cnlohr/magstock2018/revA/CompleteRevD.jpg

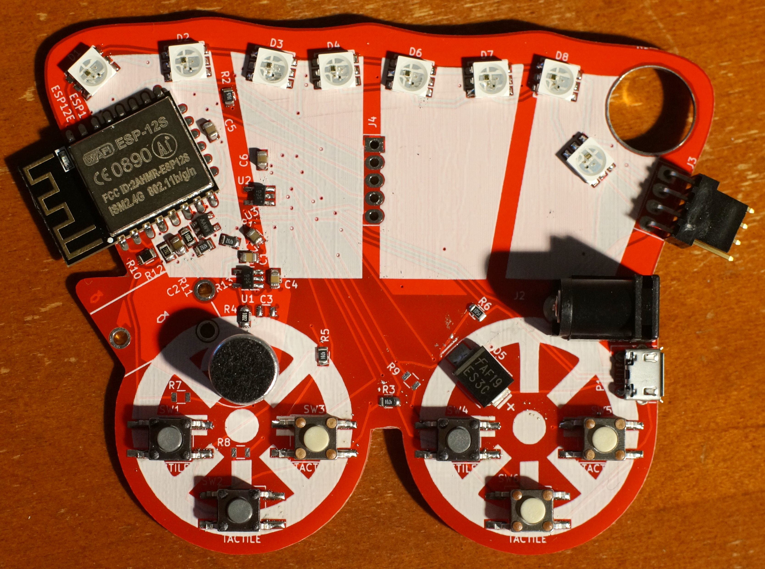
revA/CompleteRevD.jpg
