cnlohr/magstock2018/revA/WagonOutline.png

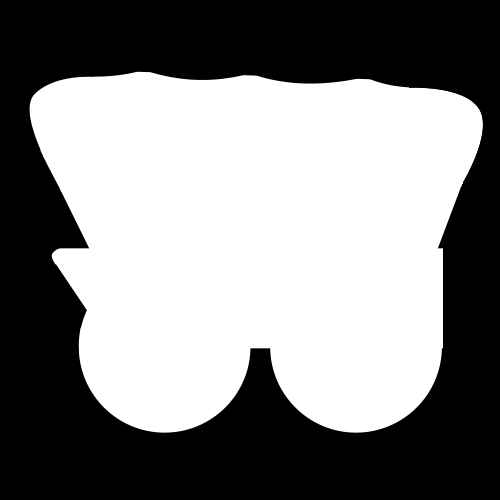
revA/WagonOutline.png
