cnlohr/magstock2018/revA/WagonSilk.png

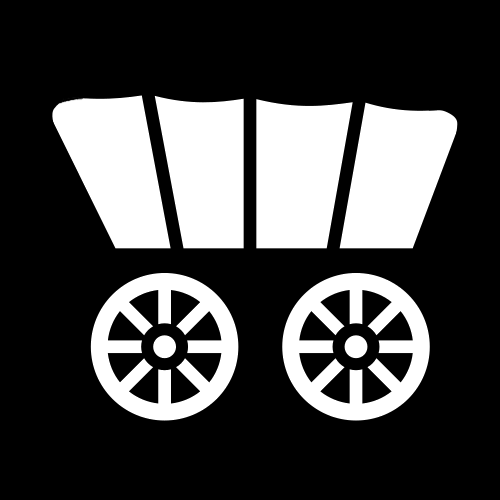
revA/WagonSilk.png
