cnlohr/magstock2018/revA/magstock2018A.kicad_pcb

## KiCad design revA/magstock2018A.kicad_pcb (2018-05-04)

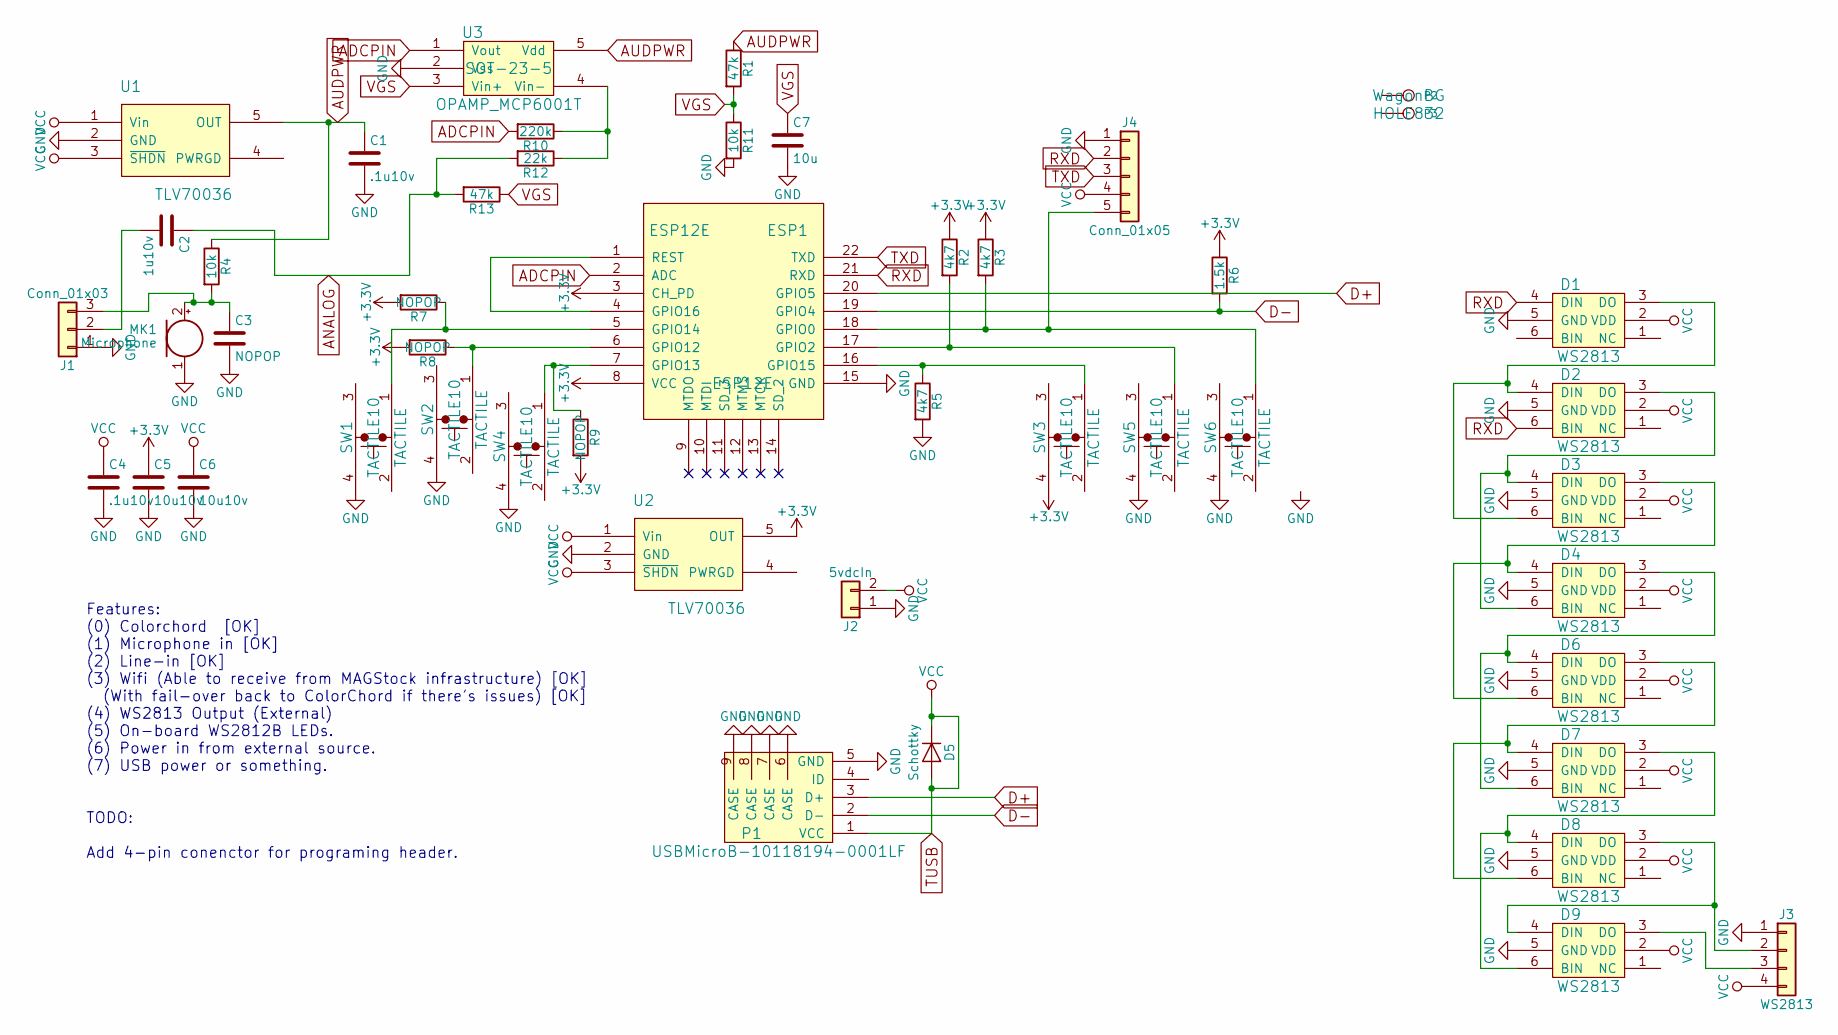
[picture p4: schematic magstock2018A.sch]

Parts:
C1, C4: .1u10v; R_0805
C2: 1u10v; R_0805
C3: NOPOP; R_0805
C5, C6: 10u10v; R_0805
C7: 10u; R_0805
D1, D2, D3, D4, D6, D7, D8, D9: WS2813
D5: Schottky; DO-214AB; Digikey SK36A R3GCT-ND
ESP1: ESP12E
J1: Conn_01x03; 3.5mm_barrel_jack_MJ-3536N; Digikey CP-3536N-ND
J2: 5vdcIn; PJ-037A; Digikey CP-037A-ND
J3: WS2813; Molex_KK-6410-04_04x2.54mm_Straight
J4: Conn_01x05; Molex_KK-6410-05_05x2.54mm_Straight
MK1: Microphone; CP_Radial_D10.0mm_P2.50mm_P5.00mm; Digikey 668-1460-ND
P1: USBMicroB-10118194-0001LF; USB_Micro-B_10103594-0001LF; Digikey 609-4050-1-ND
P2: CONN_1; WagonBG
P3: CONN_1; HOLE832
R1, R13: 47k; R_0805
R2, R3, R5: 4k7; R_0805
R4, R11: 10k; R_0805
R6: 1.5k; R_0805
R7, R8, R9: NOPOP; R_0805
R10: 220k; R_0805
R12: 22k; R_0805
SW1, SW2, SW3, SW4, SW5, SW6: TACTILE; TACTILE10; Digikey CKN9112CT-ND
U1, U2: TLV70036; SOT-23-5_HandSoldering; Digikey 296-40611-1-ND
U3: OPAMP_MCP6001T; SOT-23-5; Digikey MCP6001UT-I/OTCT-ND

Connections:
+3V3: C5.1, ESP1.3 (CH_PD), ESP1.8 (VCC), R2.1, R3.1, R6.1, R7.2, R8.2, R9.2, SW3.4, U2.5 (OUT)
ADCPIN: ESP1.2 (ADC), R10.2, U3.1 (Vout)
ANALOG: C2.1, R12.2, R13.2
AUDPWR: C1.1, R1.1, R4.1, U1.5 (OUT), U3.5 (Vdd)
D+: ESP1.20 (GPIO5), P1.3 (D+)
D-: ESP1.19 (GPIO4), P1.2 (D-), R6.2
GND: C1.2, C3.2, C4.2, C5.2, C6.2, C7.2, D1.5 (GND), D2.5 (GND), D3.5 (GND), D4.5 (GND), D6.5 (GND), D7.5 (GND), D8.5 (GND), D9.5 (GND), ESP1.15 (GND), J1.1, J2.1, J3.1, J4.1, MK1.1 (-), P1.5 (GND), P1.6 (CASE), P1.7 (CASE), P1.8 (CASE), P1.9 (CASE), R5.2, R11.2, SW1.4, SW2.4, SW4.4, SW5.4, SW6.4, U1.2 (GND), U2.2 (GND), U3.2 (Vss)
unnamed: C2.2, J1.2
unnamed: C3.1, J1.3, MK1.2 (+), R4.2
unnamed: D1.3 (DO), D2.4 (DIN), D3.6 (BIN)
unnamed: D2.3 (DO), D3.4 (DIN), D4.6 (BIN)
unnamed: D3.3 (DO), D4.4 (DIN), D6.6 (BIN)
unnamed: D4.3 (DO), D6.4 (DIN), D7.6 (BIN)
unnamed: D6.3 (DO), D7.4 (DIN), D8.6 (BIN)
unnamed: D7.3 (DO), D8.4 (DIN), D9.6 (BIN)
unnamed: D8.3 (DO), D9.4 (DIN), J3.2
unnamed: D9.3 (DO), J3.3
unnamed: ESP1.1 (REST), ESP1.4 (GPIO16)
unnamed: ESP1.5 (GPIO14), R7.1, SW1.1
unnamed: ESP1.6 (GPIO12), R8.1, SW2.1
unnamed: ESP1.7 (GPIO13), R9.1, SW4.1
unnamed: ESP1.16 (GPIO15), R5.1, SW3.1
unnamed: ESP1.17 (GPIO2), R2.2, SW5.1
unnamed: ESP1.18 (GPIO0), J4.5, R3.2, SW6.1
unnamed: R10.1, R12.1, U3.4 (Vin-)
RXD: D1.4 (DIN), D2.6 (BIN), ESP1.21 (RXD), J4.2
TUSB: C4.1, C6.1, D1.2 (VDD), D2.2 (VDD), D3.2 (VDD), D4.2 (VDD), D5.1 (K), D5.2 (A), D6.2 (VDD), D7.2 (VDD), D8.2 (VDD), D9.2 (VDD), J2.2, J3.4, J4.4, P1.1 (VCC), U1.1 (Vin), U1.3 (~SHDN), U2.1 (Vin), U2.3 (~SHDN)
TXD: ESP1.22 (TXD), J4.3
VGS: C7.1, R1.2, R11.1, R13.1, U3.3 (Vin+)

Notes on the sheet:
Features: (0) Colorchord [OK] (1) Microphone in [OK] (2) Line-in [OK] (3) Wifi (Able to receive from MAGStock infrastructure) [OK] (With fail-over back to ColorChord if there's issues) [OK] (4) WS2813 Output (External) (5) On-board WS2812B LEDs. (6) Power in from external source. (7) USB power or s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

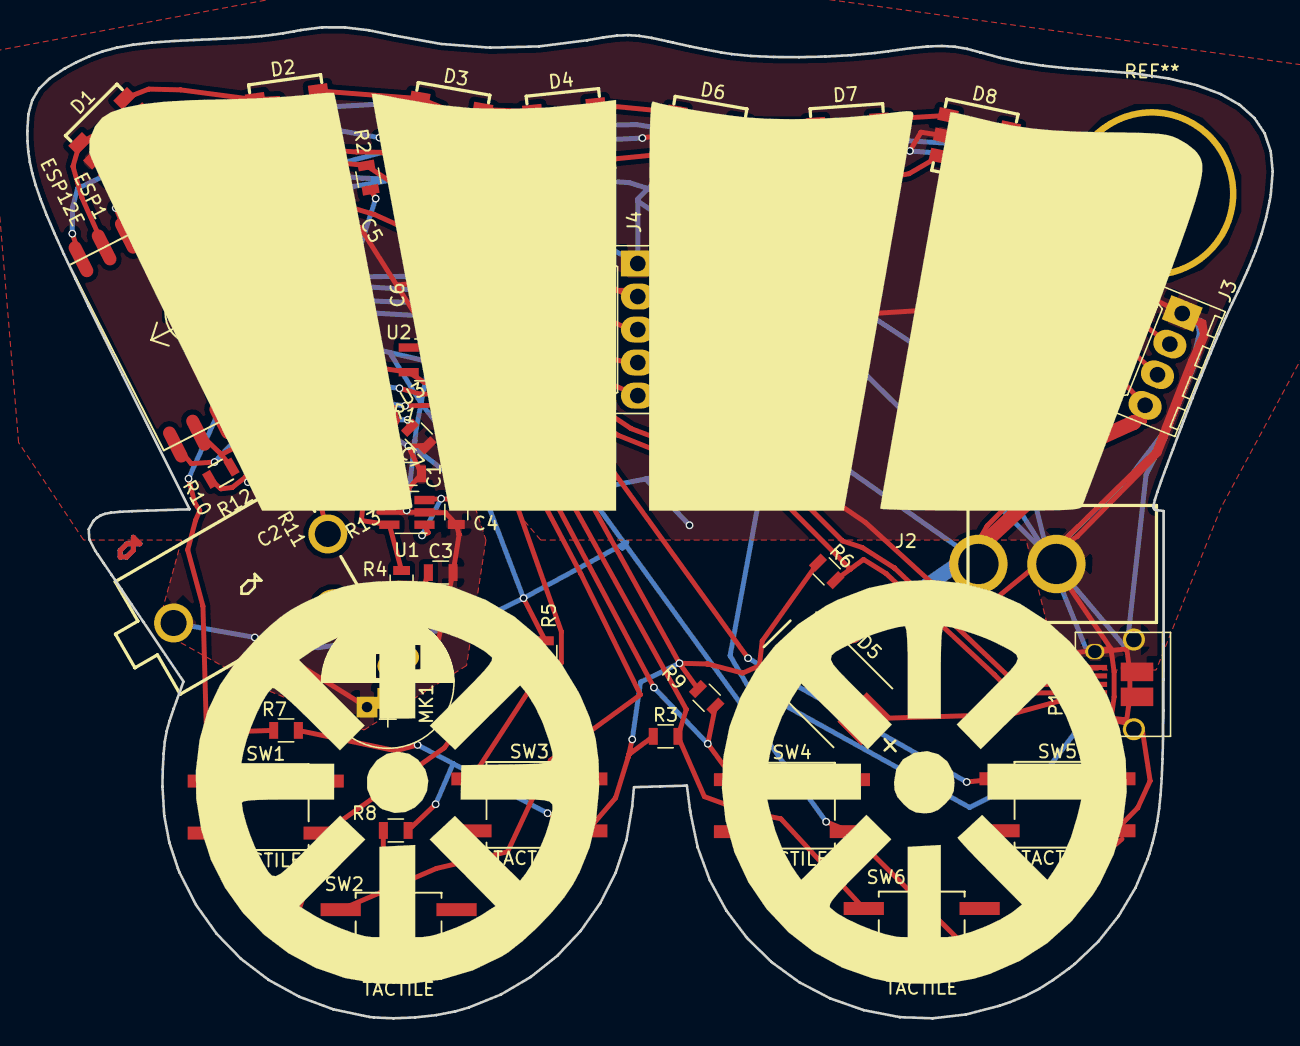
[picture p5: board magstock2018A.kicad_pcb from above]

Board: 2 copper layers, 95.8 x 76.2 mm, 46 parts (0 on the bottom side), 29 nets.
