cnlohr/magstock2018/(commit log)

2018-03-25 Commit to github.
    [magstock2018A.kicad_pcb, magstock2018A.sch]
2018-03-27 Update files
    [magstock2018A.kicad_pcb, magstock2018A.sch]
2018-03-27 Update reva
    [magstock2018A.kicad_pcb, magstock2018A.sch]
2018-04-11 Update to rev b.
    [magstock2018A-B.Cu.gbl, magstock2018A-B.Mask.gbs, magstock2018A-B.SilkS.gbo, magstock2018A-Edge.Cuts.gm1, magstock2018A-F.Cu.gtl, magstock2018A-F.Mask.gts, magstock2018A-F.Paste.gtp, magstock2018A-F.SilkS.gto]
2018-04-12 Update to optional revc
    [magstock2018A-B.Cu.gbl, magstock2018A-B.Mask.gbs, magstock2018A-B.SilkS.gbo, magstock2018A-Edge.Cuts.gm1, magstock2018A-F.Cu.gtl, magstock2018A-F.Mask.gts, magstock2018A-F.Paste.gtp, magstock2018A-F.SilkS.gto]
2018-04-20 Bump everything
    [magstock2018A-B.Cu.gbl, magstock2018A-B.Mask.gbs, magstock2018A-B.SilkS.gbo, magstock2018A-Edge.Cuts.gm1, magstock2018A-F.Cu.gtl, magstock2018A-F.Mask.gts, magstock2018A-F.Paste.gtp, magstock2018A-F.SilkS.gto]
2018-05-04 push extra wire bridge
    [magstock2018A.kicad_pcb, magstock2018A.sch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]
2018-05-04 bump rev
    [magstock2018A.csv]
2018-06-06 Add firmware
    [user.cfg]
2018-06-07 Bump all
    [user.cfg]
2018-06-07 Update code with new swadge stuff
    [user.cfg]
